rlalire/design-system-lalire/levitation-micro/cad/export/planches.pdf

## Treuil micro — planches des pièces à imprimer

Quatre pièces, trois vues et une perspective chacune. Les cotes viennent du modèle paramétrique (cad/treuil.py) ; les fichiers STEP et STL restent la référence pour la fabrication. Les vues d'une même pièce sont cadrées séparément : elles ne sont pas à la même échelle entre elles.

### Corps

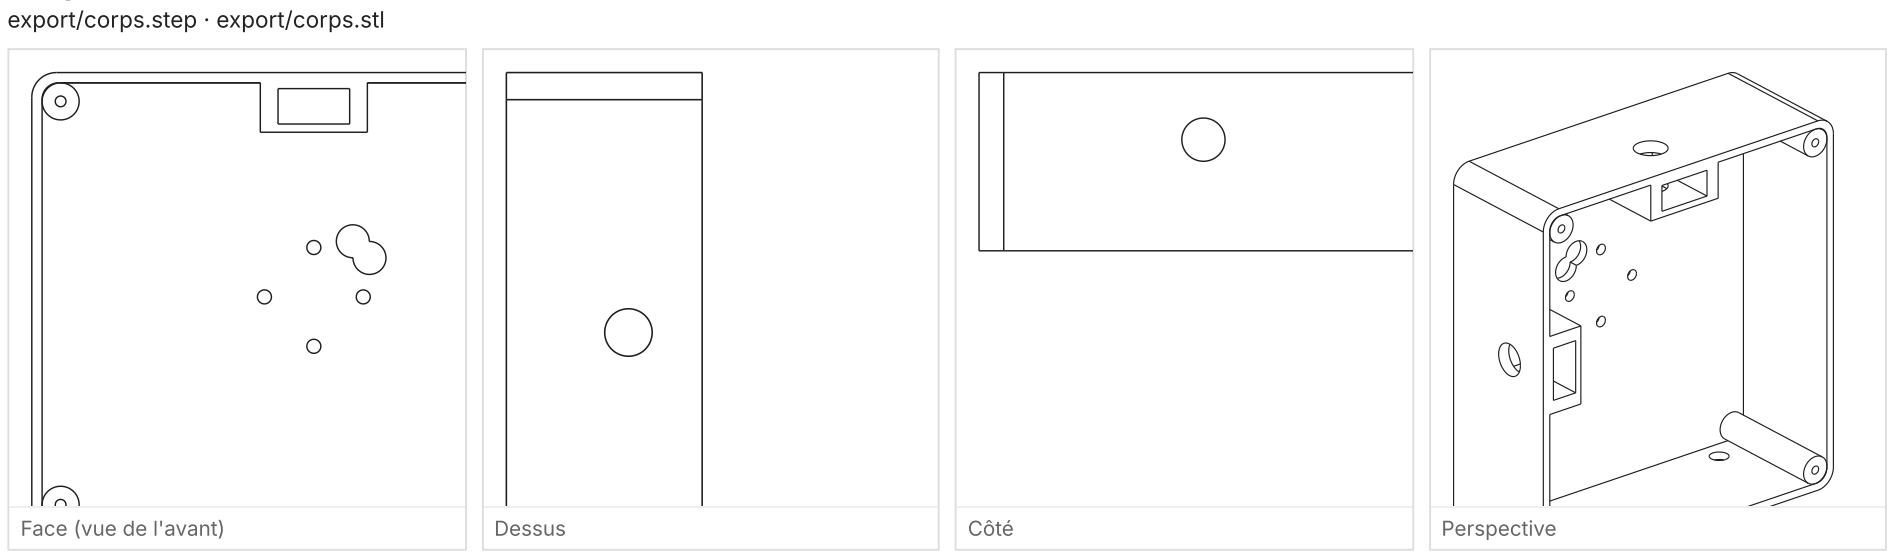
[picture p1: figure]
export/corps.step · export/corps.stl; Face (vue de l'avant); Dessus; Côté; Perspective

Encombrement | 112 × 123 × 43.3 mm
Cloison porte-moteur | épaisseur 3 mm
Fixation du moteur | 4 trous Ø 3.4 sur un cercle de 24 mm (vis M3 × 6)
Passage des fils du moteur | 2 trous Ø 8 au rayon 16.5 mm, autour de 135°
Colonnes de vissage | 4 avant-trous Ø 2.6 traversants, dans les angles
Logement de l'œillet | Ø 6.0 dans le fond, à 40.0 mm de l'axe
Accroche | 2 bossages avec écrou M10 prisonnier (17 sur plats) et trou Ø 10,5, à 27 mm de la cloison : un sur le dessus, un sur le côté
Élingue de sécurité | anneau à vis M10 dans l'emplacement de spigot resté libre

Parois | 2.5 mm
Volume | 103.9 cm³
Matière conseillée | nylon PA12 (MJF) ou PETG
Sens d'impression | cloison sur le plateau, sans supports

### Capot Arriere

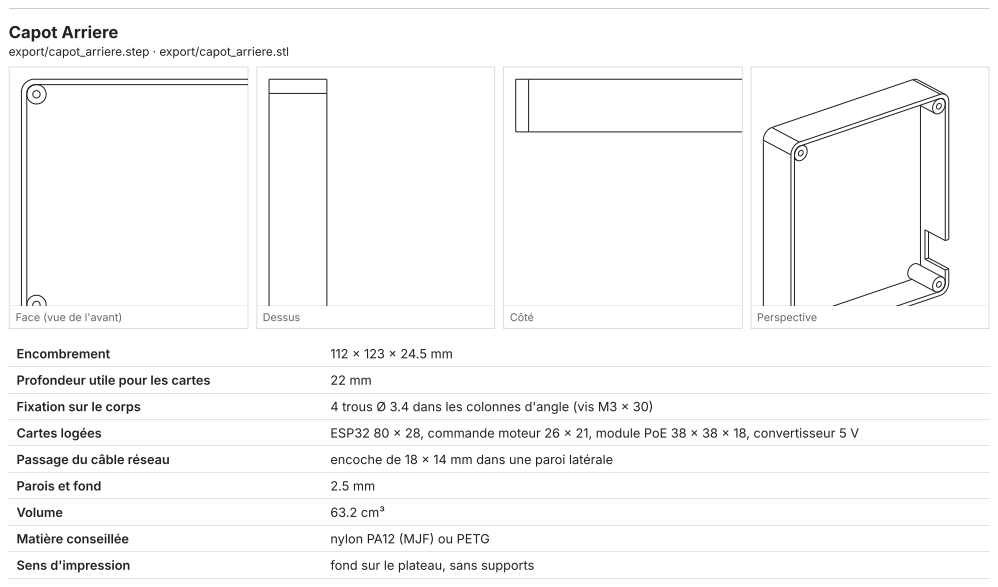
[picture p2: page 3]
Face (vue de l'avant); Dessus; Côté; Perspective; Encombrement; Profondeur utile pour les cartes; Fixation sur le corps; 4 trous Ø 3.4 dans les colonnes d'angle (vis M3 × 30); Cartes logées; ESP32 80 × 28, commande moteur 26 × 21, module PoE 38 × 38 × 18, convertisseur 5 V; Passage du câble réseau; encoche de 18 × 14 mm dans une paroi latérale; Parois et fond; Volume; 63.2 cm³; Matière conseillée; nylon PA12 (MJF) ou PETG; Sens d'impression; fond sur le plateau, sans supports

export/capot_arriere.step · export/capot_arriere.stl

### Couvercle Avant

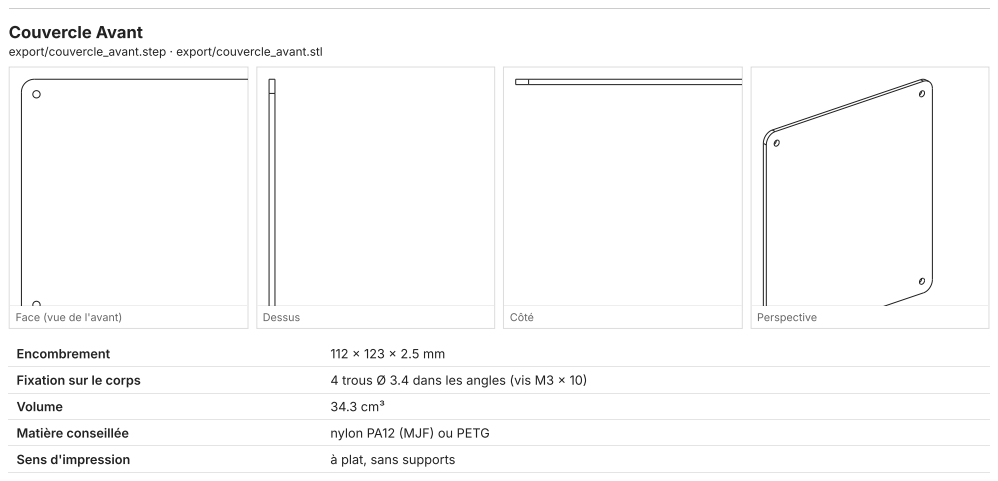
[picture p3: page 4]
Face (vue de l'avant); Dessus; Côté; Perspective; Encombrement; Fixation sur le corps; 4 trous Ø 3.4 dans les angles (vis M3 × 10); Volume; 34.3 cm³; Matière conseillée; nylon PA12 (MJF) ou PETG; Sens d'impression; à plat, sans supports

export/couvercle_avant.step · export/couvercle_avant.stl

### Bobine

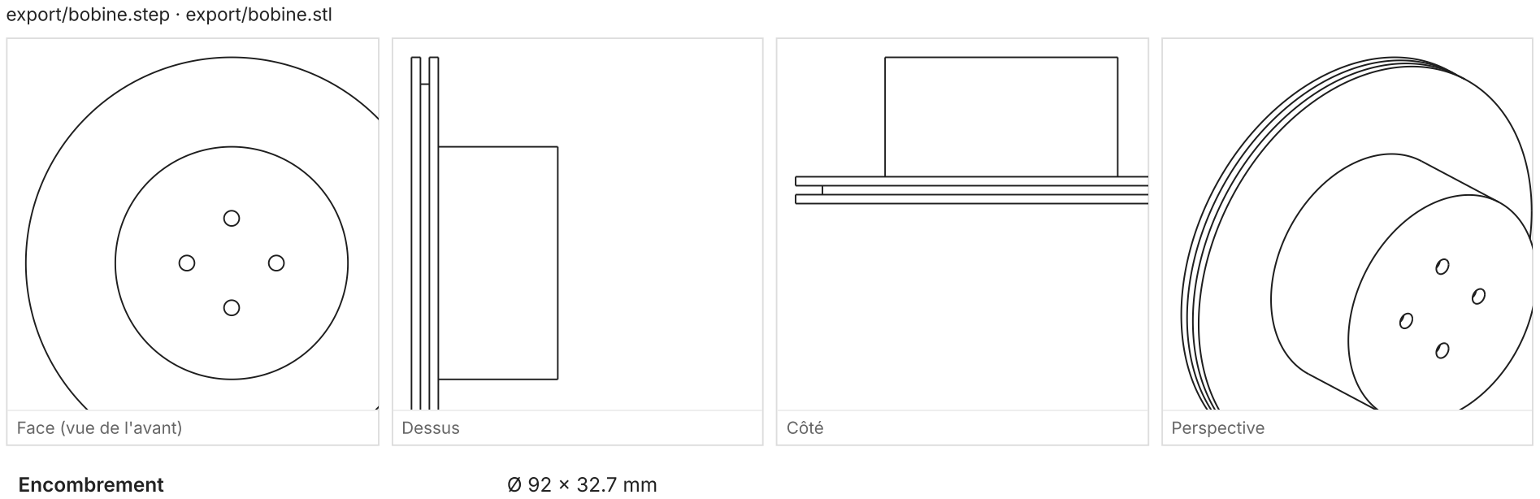
[picture p4: figure]
export/bobine.step · export/bobine.stl; Face (vue de l'avant); Dessus; Côté; Perspective; Encombrement

Fond de gorge | Ø 80 mm, soit 251.5 mm de fil par tour
Gorge | 2 mm de large, 6 mm de profondeur, joues de 2 mm
Logement du moteur | Ø 46 mm (moteur de 41.8 mm)
Fond de la cloche | 3.0 mm d'épaisseur
Fixation sur le moteur | 4 trous Ø 3.4 sur un cercle de 20 mm (vis M3 × 5, pas plus longues)
Téton de centrage | Ø 5.8 × 1.2 mm, dans l'alésage de 6 mm du moteur
Ancrage du fil | trou Ø 1 dans la joue arrière
Volume | 43.9 cm³
Matière conseillée | résine (SLA), surface lisse
Sens d'impression | fond de la cloche sur le plateau, sans supports
