rlalire/design-system-lalire/levitation-micro/cad/export/capot_arriere.step

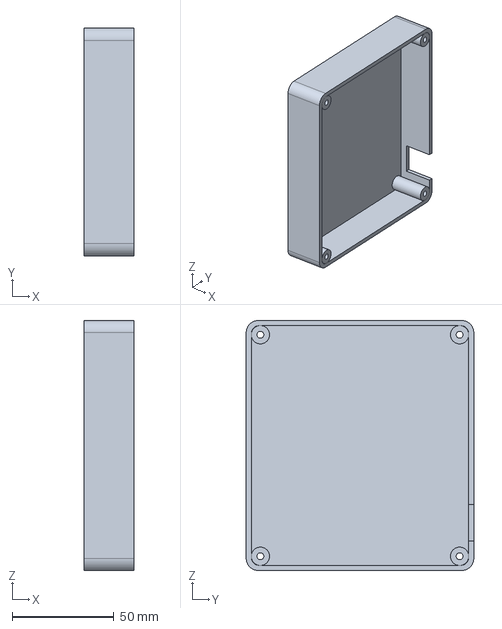
[picture p5: CAD file, 2026-11-14]
levitation-micro/cad/export/capot_arriere.step
24.5 x 112.0 x 123.0 mm
