rlalire/design-system-lalire/levitation-prise-directe/cad/export/bobine.step

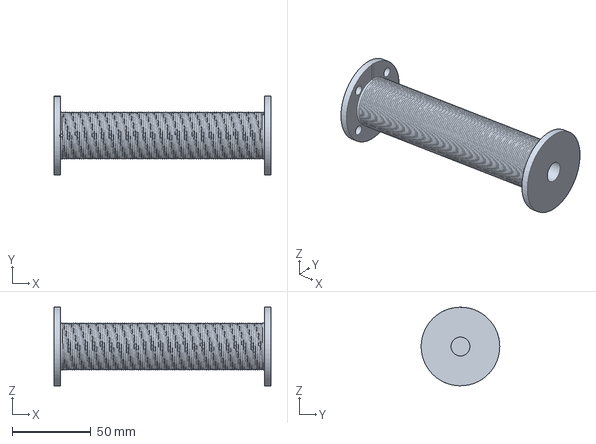
[picture p6: CAD file, 2026-11-10]
levitation-prise-directe/cad/export/bobine.step
138.0 x 50.0 x 50.0 mm
