rlalire/design-system-lalire/levitation/cad/export/flasque_gauche.step

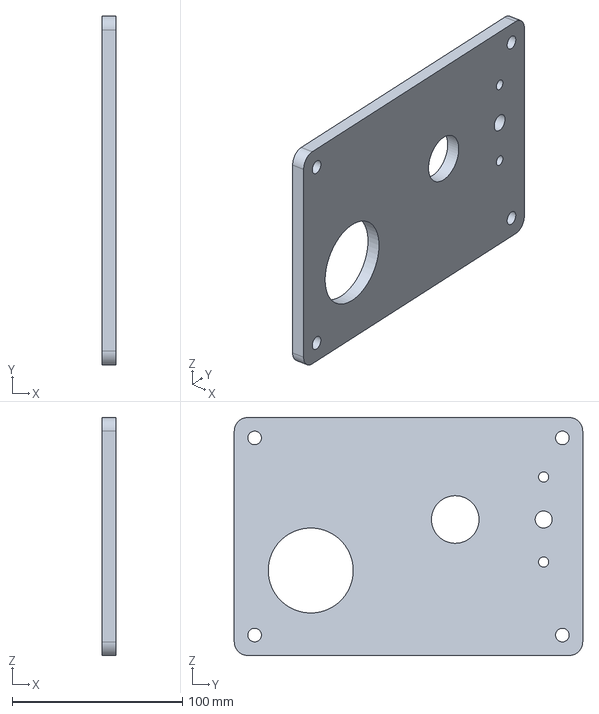
[picture p7: CAD file, 2026-11-10]
levitation/cad/export/flasque_gauche.step
8.00 x 205.0 x 140.0 mm
