rlalire/design-system-lalire/levitation-bobine-plate/cad/export/platine.step

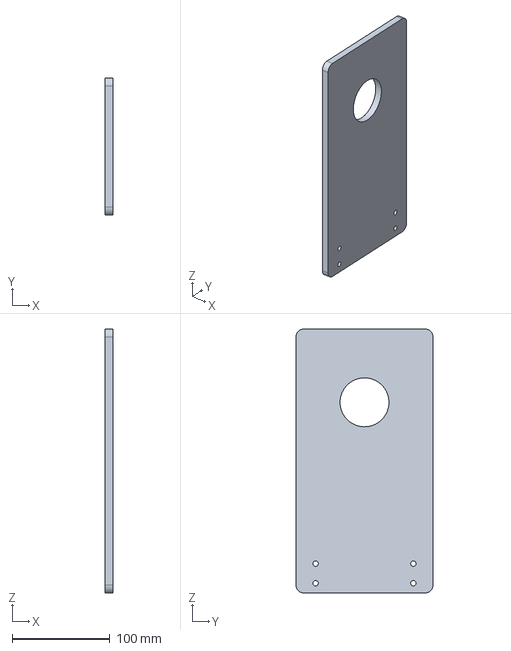
[picture p8: CAD file, 2026-11-10]
levitation-bobine-plate/cad/export/platine.step
8.00 x 140.0 x 270.0 mm
