rlalire/design-system-lalire/levitation-micro/cad/export/bobine.step

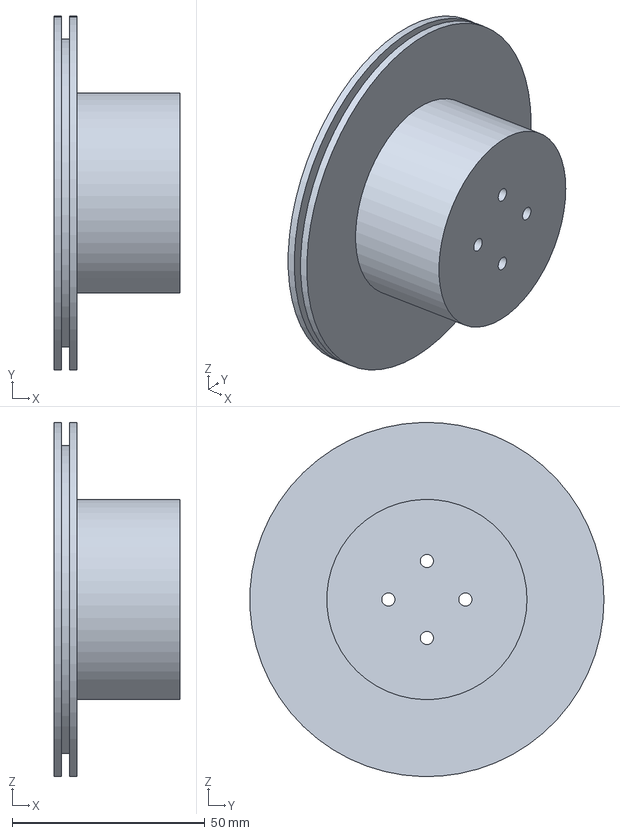
[picture p9: CAD file, 2026-11-14]
levitation-micro/cad/export/bobine.step
32.7 x 91.9 x 92.0 mm
