rlalire/design-system-lalire/levitation-micro/cad/export/treuil.step

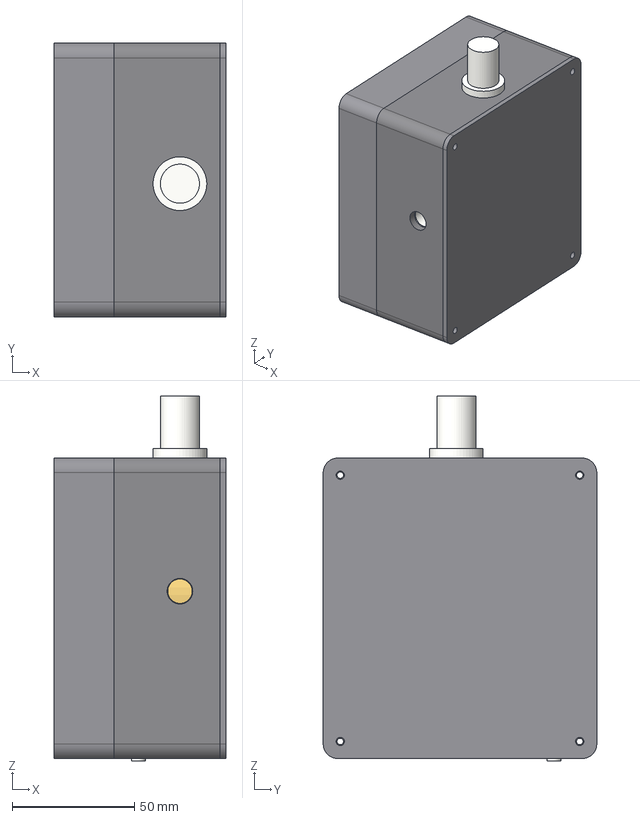
[picture p11: CAD file, 2026-11-14]
levitation-micro/cad/export/treuil.step
70.3 x 112.0 x 149.4 mm
corps
capot_arriere
couvercle_avant
moteur
bobine
oeillet
ecrou_m10
ecrou_m10_cote
spigot
carte_esp32
commande_moteur
module_poe
convertisseur_5v
