rlalire/design-system-lalire/levitation-prise-directe/cad/export/treuil.step

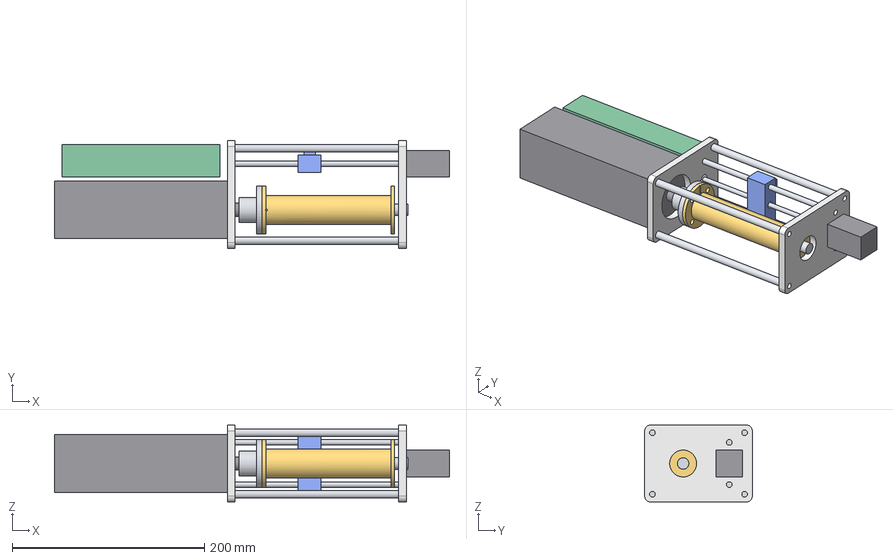
[picture p12: CAD file, 2026-11-10]
levitation-prise-directe/cad/export/treuil.step
411.0 x 112.0 x 80.0 mm
servo
flasque_moteur
moyeu
bobine
axe_palier
flasque_palier
vis_guide
colonne_haute
colonne_basse
moteur_guide
chariot
electronique
entretoise_1
entretoise_2
entretoise_3
entretoise_4
