rlalire/design-system-lalire/levitation/cad/export/treuil.step

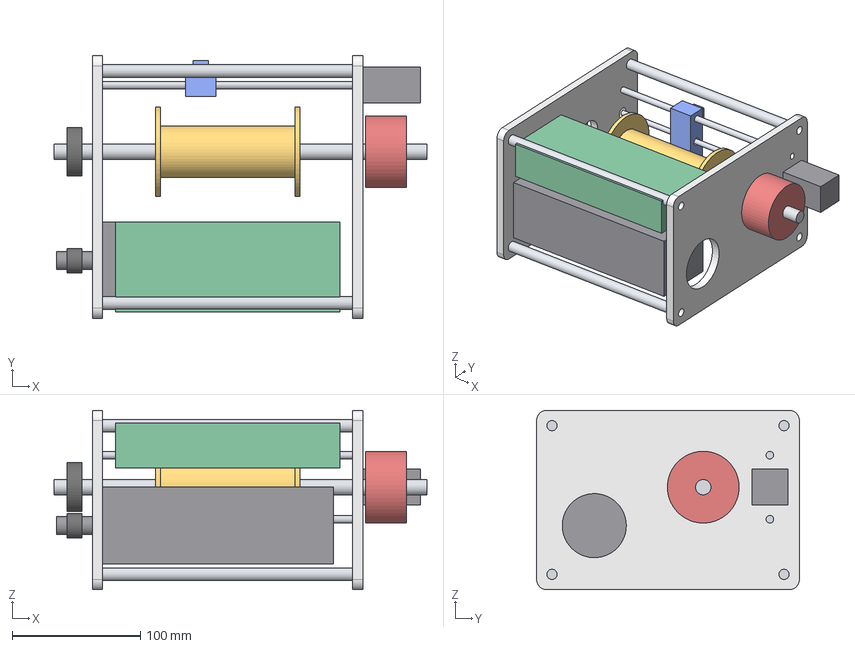
[picture p13: CAD file, 2026-11-10]
levitation/cad/export/treuil.step
291.0 x 205.0 x 140.0 mm
flasque_gauche
flasque_droit
tambour
axe
servo
poulie_moteur
poulie_tambour
frein
vis_guide
colonne_haute
colonne_basse
moteur_guide
chariot
electronique
entretoise_1
entretoise_2
entretoise_3
entretoise_4
