rlalire/design-system-lalire/levitation-bobine-plate/cad/export/support_poulie.step

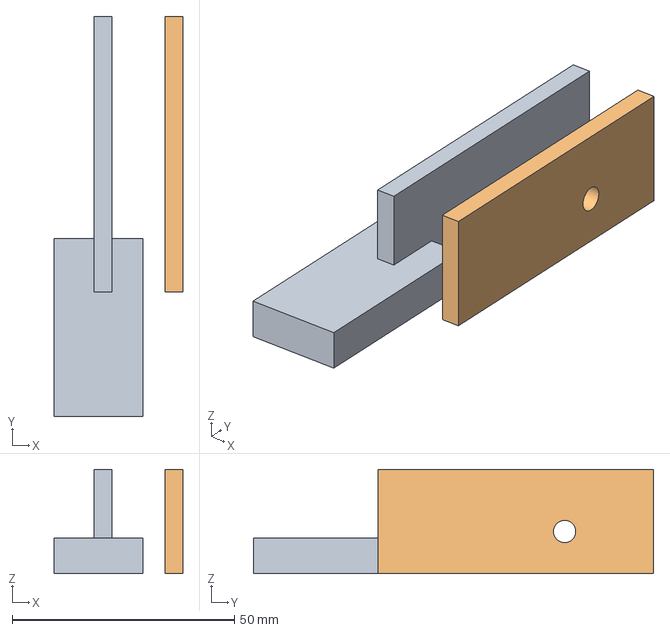
[picture p14: CAD file, 2026-11-10]
levitation-bobine-plate/cad/export/support_poulie.step
29.0 x 90.0 x 23.5 mm
