rlalire/design-system-lalire/levitation-micro/cad/export/corps.step

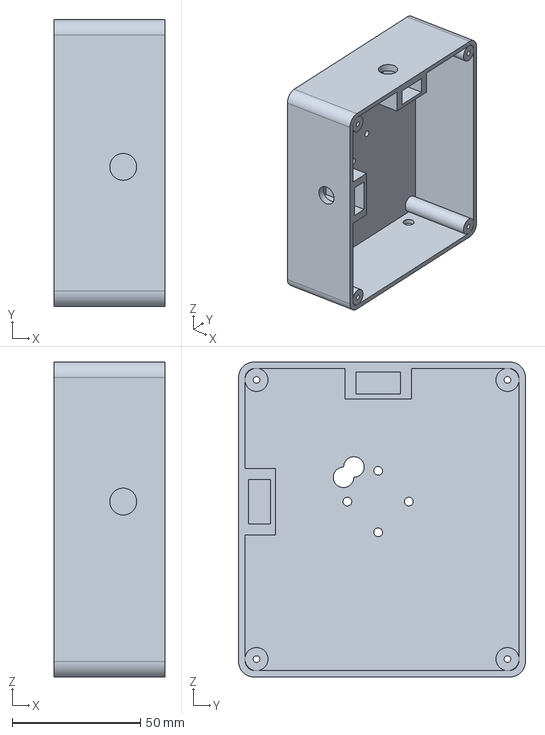
[picture p15: CAD file, 2026-11-14]
levitation-micro/cad/export/corps.step
43.3 x 112.0 x 123.0 mm
