rlalire/design-system-lalire/levitation-prise-directe/cad/export/chariot.step

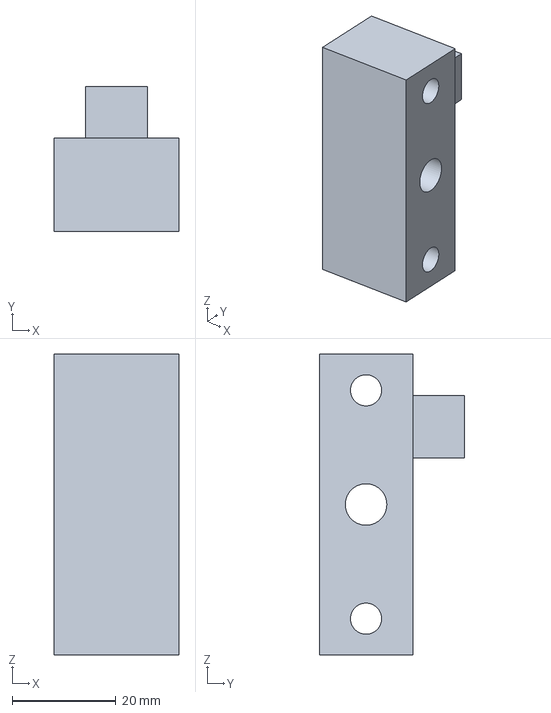
[picture p16: CAD file, 2026-11-10]
levitation-prise-directe/cad/export/chariot.step
24.0 x 28.0 x 58.0 mm
