rlalire/design-system-lalire/levitation/cad/export/tambour.step

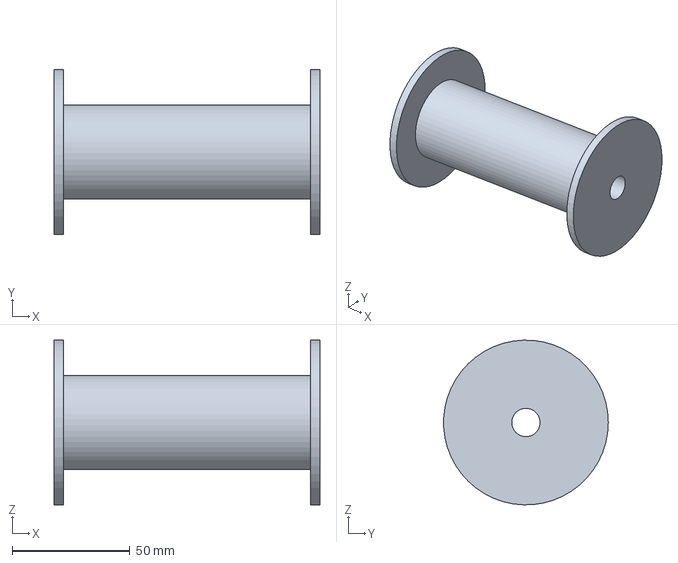
[picture p17: CAD file, 2026-11-10]
levitation/cad/export/tambour.step
113.0 x 69.9 x 70.0 mm
