rlalire/design-system-lalire/levitation-micro/cad/export/couvercle_avant.step

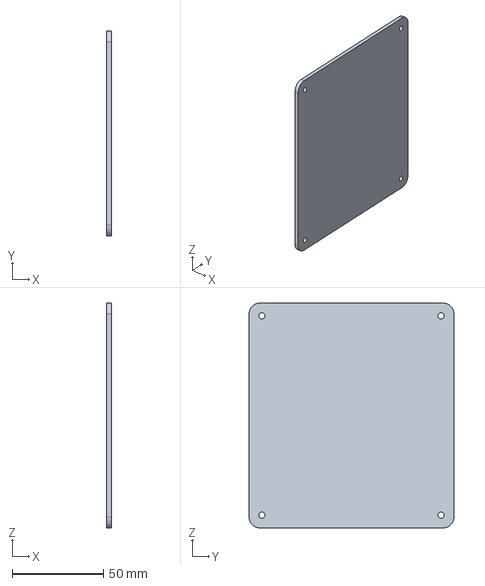
[picture p18: CAD file, 2026-11-14]
levitation-micro/cad/export/couvercle_avant.step
2.50 x 112.0 x 123.0 mm
