rlalire/design-system-lalire/levitation-prise-directe/cad/export/flasque_palier.step

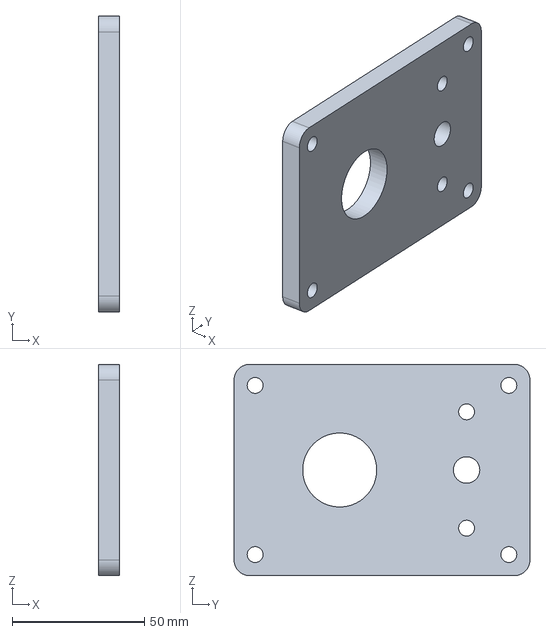
[picture p19: CAD file, 2026-11-10]
levitation-prise-directe/cad/export/flasque_palier.step
8.00 x 112.0 x 80.0 mm
