rlalire/design-system-lalire/levitation/cad/export/chariot.step

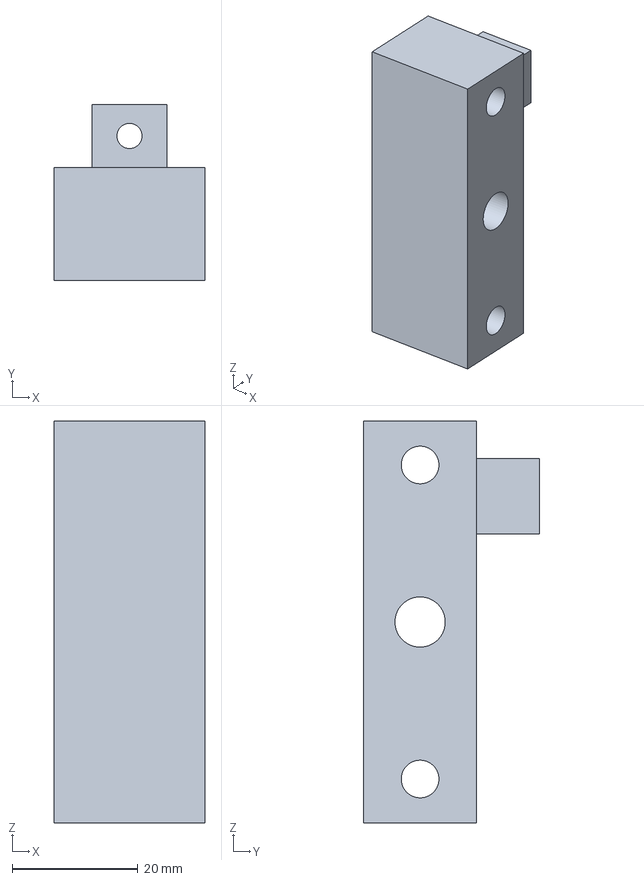
[picture p20: CAD file, 2026-11-10]
levitation/cad/export/chariot.step
24.0 x 28.0 x 64.0 mm
