rlalire/design-system-lalire/levitation-bobine-plate/cad/export/treuil.step

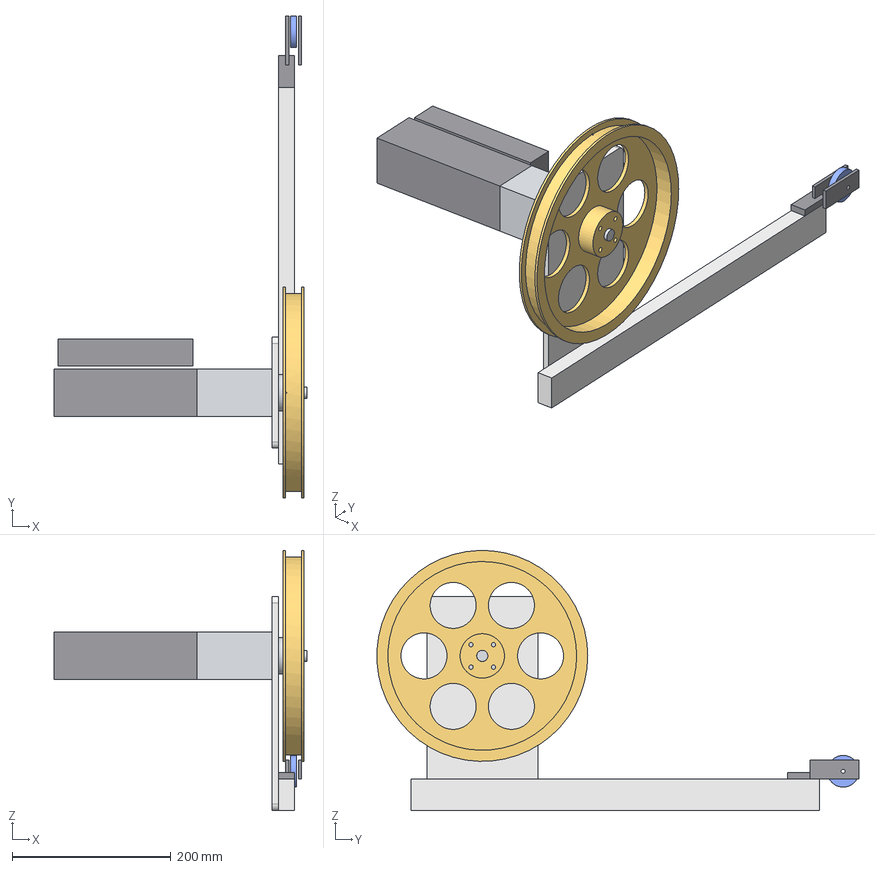
[picture p21: CAD file, 2026-11-10, an earlier design]
levitation-bobine-plate/cad/export/treuil.step
319.0 x 607.7 x 327.9 mm
servo
reducteur
platine
moyeu_acier
bobine
profile_2040
support_poulie
poulie
electronique
