rlalire/design-system-lalire/(list of files, cad)

Other CAD files:
levitation/cad/export/flasque_droit.step
levitation-bobine-plate/cad/export/bobine.step
levitation-bobine-plate/cad/export/bobine.stl
levitation-micro/cad/export/bobine.stl
levitation-micro/cad/export/capot_arriere.stl
levitation-micro/cad/export/corps.stl
levitation-micro/cad/export/couvercle_avant.stl
levitation-prise-directe/cad/export/bobine.stl
