rlalire/design-system-lalire/(commit log)

2026-11-10 Add levitation winch block: design dossier, firmware and CAD mock-up
    Design v0.1 of a synchronised winch block (400 W integrated servo, 2:1
    belt, single-layer drum, stepper-driven level wind, power-off brake)
    controlled over Ethernet with OSC.
    - README: sizing, parts list, wiring, OSC protocol, safety notes
    - firmware: ESP32 (Olimex ESP32-POE) controller with a desktop
    simulation that exercises the full motion and safety logic
    - cad: parametric CadQuery layout with STEP and SVG exports
    Claude-Session: https://claude.ai/code/session_017DCVp2yKAUFFRUNcd5dRpr
    [chariot.step, flasque_droit.step, flasque_gauche.step, tambour.step, treuil.step]
2026-11-10 Use the brake version of the servo and update its dimensions
    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
    [chariot.step, flasque_droit.step, flasque_gauche.step, tambour.step, treuil.step]
2026-11-10 Add direct-drive winch variant with printable spool and 3D simulation
    Spool mounted on the servo shaft, no belt. Includes a grooved spool
    ready for 3D printing (STL and STEP), firmware settings for the new
    mechanics, and an interactive 3D view of the mechanism.
    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
    [bobine.step, bobine.stl, chariot.step, flasque_moteur.step, flasque_palier.step, treuil.step]
2026-11-10 Add flat-spool winch variant with planetary gearbox and fixed exit pulley
    250 mm single-layer spool on a 10:1 planetary gearbox, line guided to a
    fixed exit pulley so the exit point never moves. Includes the printable
    spool, frame parts, firmware settings and an interactive 3D view.
    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
    [bobine.step, bobine.stl, platine.step, support_poulie.step, treuil.step]
2026-11-11 Add micro winch variant for very light objects on hair-thin thread
    Enclosed 112 x 135 x 50 mm block: flat stepper in direct drive, narrow
    80 mm spool, fixed ceramic exit eyelet, single PoE cable. Firmware gets
    a separate descent speed limit. All variants now save the position as
    soon as the block is idle, so it survives a power cut while armed.
    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
    [bobine.step, bobine.stl, boitier.step, couvercle_arriere.step, couvercle_avant.step, treuil.step]
2026-11-11 Switch the micro winch to a gimbal motor with torque control
    CubeMars GL35 with encoder driven through SimpleFOC. The spool is now a
    cup bolted on the rotor face. Firmware controls the motor in torque
    mode: capped thread tension, snag detection, gentle stall homing and a
    thread break test. The desktop simulation now models the motor, spool
    and hanging load.
    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
    [bobine.step, bobine.stl, boitier.step, couvercle_arriere.step, couvercle_avant.step, treuil.step]
2026-11-11 Use the GL35 dimensional drawing for the motor mounting holes
    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
    [bobine.step, bobine.stl, boitier.step, couvercle_arriere.step, couvercle_avant.step, treuil.step]
2026-11-12 Redraw the micro winch around the housed G35 motor drawing
    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
    [bobine.step, bobine.stl, boitier.step, couvercle_arriere.step, couvercle_avant.step, treuil.step]
2026-11-12 Build the micro winch around the manufacturer's G35 3D file
    Mounting holes, wire exit and hub position now come from the vendor
    STEP file, which is included in the assembly.
    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
    [G35_sans_driver.stp, bobine.step, bobine.stl, boitier.step, couvercle_arriere.step, couvercle_avant.step, treuil.step]
2026-11-12 Make the micro winch enclosure printable for the prototype
    Enclosure split into three support-free parts (body with motor bulkhead,
    rear tray, front cover) with corner screw columns, a centring collar on
    the spool, per-part STEP and STL files, and part sheets with dimensions.
    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
    [bobine.step, bobine.stl, boitier.step, capot_arriere.step, capot_arriere.stl, corps.step, corps.stl, couvercle_arriere.step]
2026-11-12 Rebuild the micro winch around the GL35 with encoder
    CubeMars confirmed the G35 is discontinued and the GL35 KV100 with an
    AS5048A encoder replaces it. Parts, sheets, simulation and dossier now
    use its drawing (41.8 x 33.5 mm) and the confirmed electrical values.
    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
    [G35_sans_driver.stp, bobine.step, bobine.stl, capot_arriere.step, corps.step, corps.stl, couvercle_avant.step, couvercle_avant.stl]
2026-11-12 Hang the micro winch from an M10 spigot for clamp mounting
    A captive M10 nut in the body takes a 16 mm spigot on top, in line with
    the motor. One lug remains for a safety cable, and the network cable now
    leaves through the side of the rear tray.
    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
    [bobine.step, capot_arriere.step, capot_arriere.stl, corps.step, corps.stl, couvercle_avant.step, treuil.step]
2026-11-12 Add a side spigot mount to the micro winch body
    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
    [bobine.step, capot_arriere.step, corps.step, corps.stl, couvercle_avant.step, treuil.step]
2026-11-12 Remove the top lug from the micro winch body
    The free spigot position now takes an M10 eye bolt for the safety cable.
    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
    [bobine.step, capot_arriere.step, corps.step, corps.stl, couvercle_avant.step, treuil.step]
2026-11-12 Size the micro winch rear tray for real boards and document the power chain
    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
    [bobine.step, capot_arriere.step, capot_arriere.stl, corps.step, couvercle_avant.step, treuil.step]
2026-11-12 Add a shopping list for the micro winch prototype
    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
2026-11-12 Document wiring precautions and tooling for the micro winch
    Move the encoder data input to a free pin on the Olimex board and
    record the PoE and USB precaution, network setup, soldering needs and
    the tools missing from the shopping list.
    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
    [config.h]
2026-11-12 Compile all firmware variants for the ESP32 board
    Pin library versions that exist and match the ESP32 core (SimpleFOC
    2.3.3, FastAccelStepper 1.4.0). The micro firmware now uses space-vector
    modulation with a voltage limit the supply can deliver. Add ready-to-
    flash images for micro blocks 1 to 4.
    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
2026-11-14 Fit the micro winch eyelet seat to flanged 6 mm ceramic eyelets
    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
    [bobine.step, capot_arriere.step, corps.step, corps.stl, couvercle_avant.step, treuil.step]
2026-11-14 Add a group stop to the micro winch firmware
    A block entering a fault now broadcasts /levi/all/groupstop and repeats
    it while faulted. The other blocks stop smoothly, keep holding and
    refuse goto and pos until reset. State feedback gains a seventh value
    naming the block that triggered the stop. Ready-to-flash images rebuilt.
    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
    [main.cpp, sim.cpp]
2026-11-14 Add height reporting and a length-measure command to the micro firmware
    Homing now reports the distance wound up, which gives the block height
    when the object starts on the floor. A new measure command winds gently
    at a capped tension until the thread goes taut, reports the length and
    gives slack back, without changing the origin. Images rebuilt.
    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
